drupchen/microdox-tent/docs/build_preview.3mf

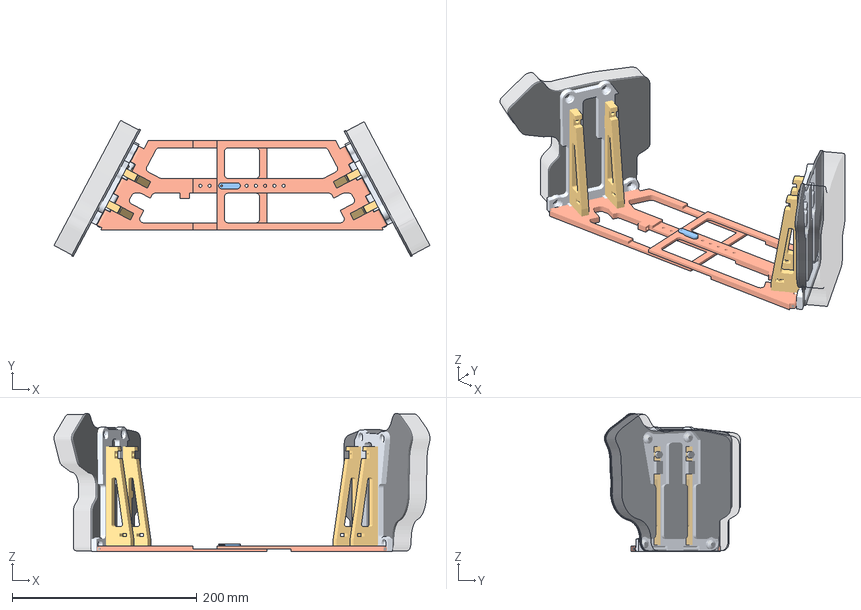
[picture p3: CAD file, 2026-11-09]
docs/build_preview.3mf
406.5 x 147.5 x 149.6 mm
