drupchen/microdox-tent/stl/vertical/print_set.3mf

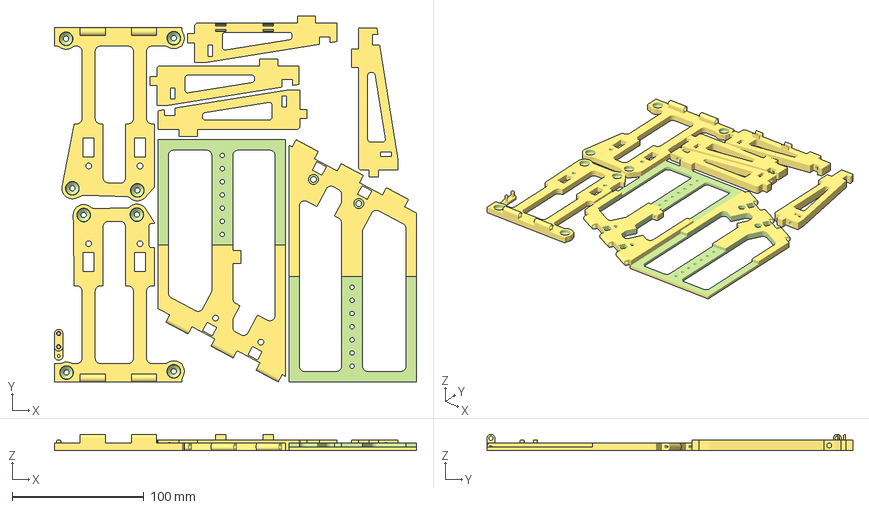
[picture p4: CAD file, 2026-11-09]
stl/vertical/print_set.3mf
275.0 x 277.9 x 12.5 mm
