drupchen/microdox-tent/trackball_retainer.stl

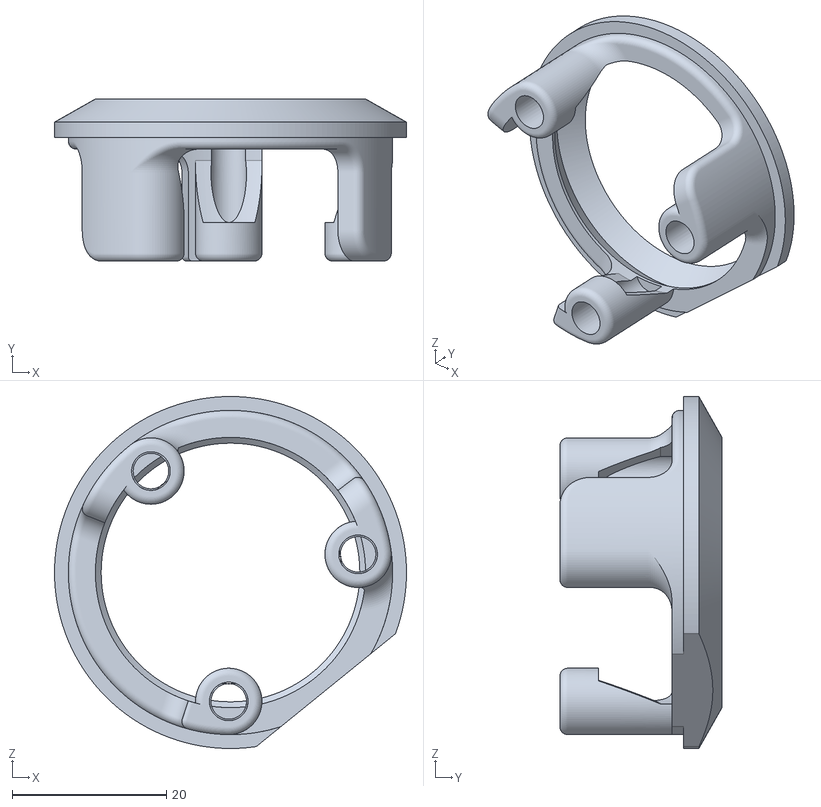
[picture p5: CAD file, 2026-11-09]
trackball_retainer.stl
45.6 x 21.0 x 45.6
