drupchen/microdox-tent/stl/vertical/spine_right.stl

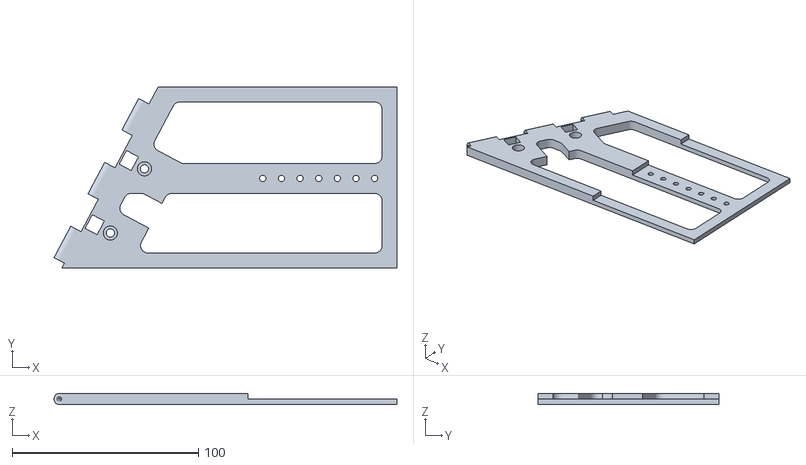
[picture p6: CAD file, 2026-11-09]
stl/vertical/spine_right.stl
184.0 x 97.0 x 6.00
