drupchen/microdox-tent/stl/vertical/haunch_key.stl

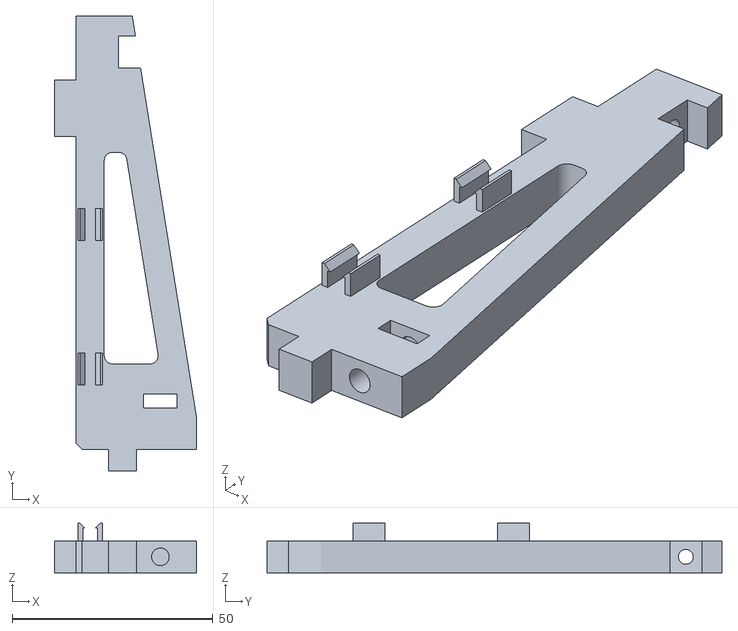
[picture p7: CAD file, 2026-11-09]
stl/vertical/haunch_key.stl
35.4 x 113.4 x 12.4
