drupchen/microdox-tent/stl/vertical/lap_staple.stl

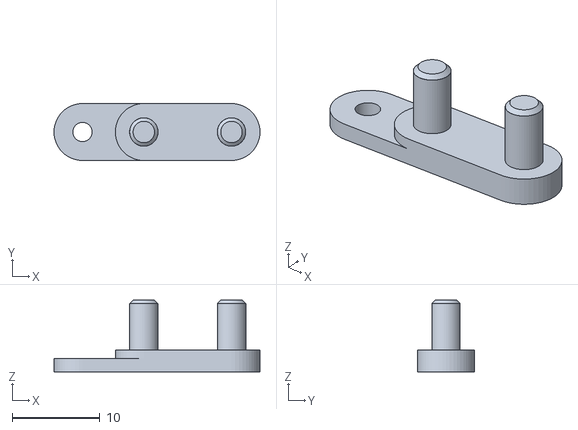
[picture p8: CAD file, 2026-11-09]
stl/vertical/lap_staple.stl
23.5 x 6.50 x 8.19
