drupchen/microdox-tent/stl/vertical/haunch.stl

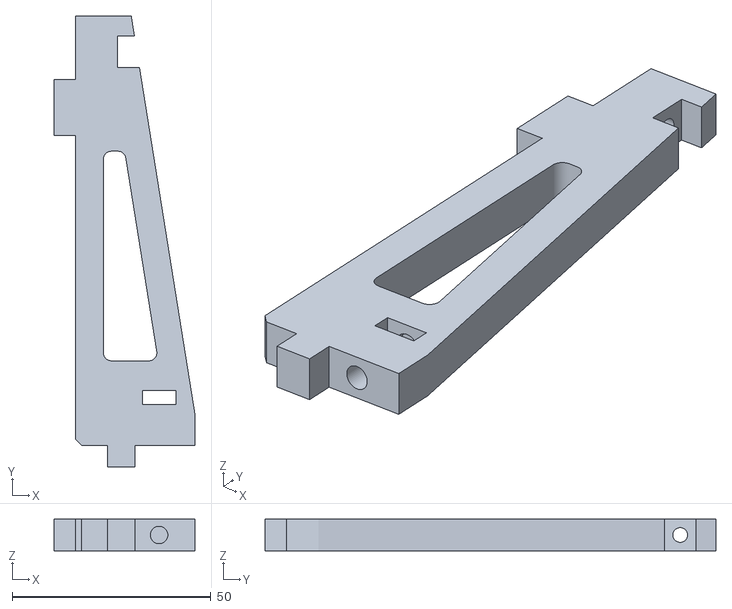
[picture p9: CAD file, 2026-11-08]
stl/vertical/haunch.stl
35.4 x 113.4 x 8.00
