drupchen/microdox-tent/stl/vertical/wall_right.stl

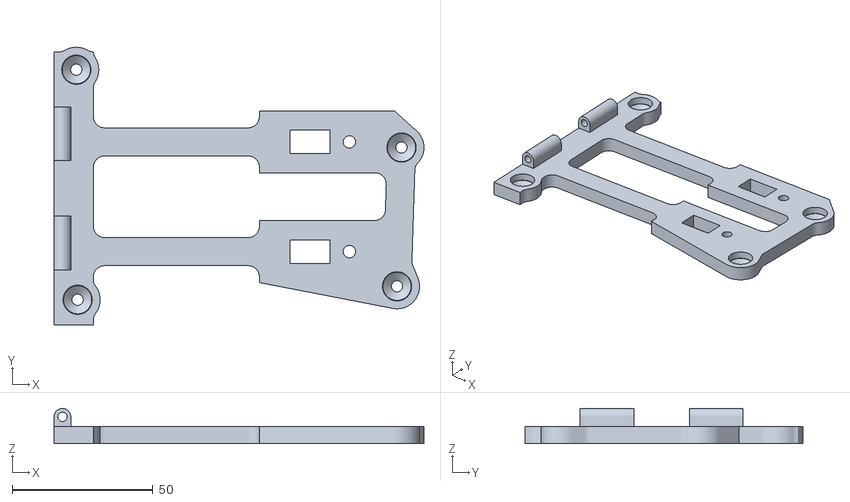
[picture p10: CAD file, 2026-11-08]
stl/vertical/wall_right.stl
131.5 x 98.6 x 12.5
