drupchen/microdox-tent/stl/vertical/wall_left.stl

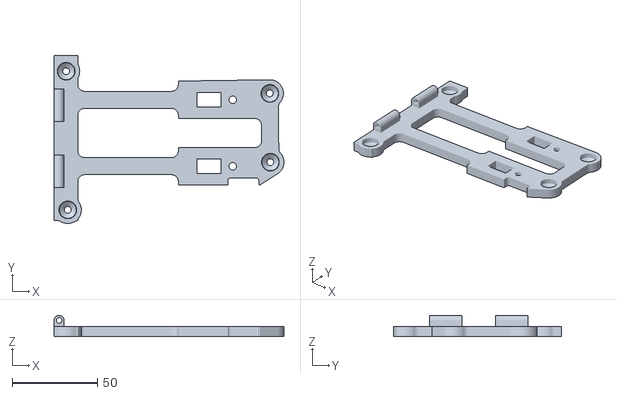
[picture p11: CAD file, 2026-11-08]
stl/vertical/wall_left.stl
135.1 x 98.6 x 12.5
