drupchen/microdox-tent/(list of files, cad)

Other CAD files:
stl/vertical/spine_left.stl
stl/vertical/print_set.stl
