drupchen/microdox-tent/(commit log)

2026-11-06 Rename project to Charybdis tent and update details
    Updated README to reflect project name change and enhancements for the Charybdis tenting stand, including design details and assembly instructions.
2026-11-07 90 deg: vertical stand, and the measurements that go with it
    The board is now vertical and staying there, so the target angle changes from
    "~70-75, to be found in cardboard" to a settled 90. That turns out to change the
    architecture, not just a number.
    cad/vertical.scad: a new stand, because the Ribs wedge cannot be re-parameterised
    to 90 - plate_in_x() collapses from ~87 mm at 30 deg to plate_t at 90, foot_x()
    goes negative and the ribs invert through the plate. Three flat plates per half
    (wall, two braces, base) slotted together; the wall passes through the base to the
    desk so load goes straight down. 86 g per half, 172 g the pair, against the ~400 g
    a 90 deg wedge would need. Wall and br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
    [base.stl, base_right.stl, brace.stl, microdox_ribs.scad, vertical.scad, wall.stl]
2026-11-07 docs: render of the vertical assembly
    Claude-Session: https://claude.ai/code/session_011RvQQieD5SvLoYgEtfii7x
2026-11-08 vertical: move the structure inboard; splay in the flange; rest kit
    The base-plate version of this file was wrong in two ways that reinforced
    each other. The plate was 62% of each half's mass and set a 318 x 105 mm
    footprint, and it put every bit of structure OUTBOARD, under the hands,
    while leaving the ~160 mm of air between the two vertical halves empty. At
    90 deg that gap is dead space - no hands, no keycaps, no cables - and it is
    the only place structure does not get in the way.
    Everything moved inboard. Two walls, and a spine between them whose outer
    ends turn up into flanges the walls bolt to face-to-face. No base plates, no
    braces, no feet: a bolted lap is already a moment connection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
    [base.stl, base_right.stl, brace.stl, carrier.stl, pad_ring_ref.scad, rest_arm.stl, spine_left.stl, spine_right.stl]
2026-11-08 cad: Charybdis 4x6 bottom-plate geometry, from upstream's own files
    This is the measurement the whole project has been blocked on. Drupchen
    identified Bastardkb/charybdis files/4x6/MK1/plate_shield2.x.stl as matching
    his physical plate bar the on/off and reset openings, and that folder also
    ships plate_shield2.x.dxf - the 2D source, with exact circles rather than a
    faceted mesh.
    Eight CIRCLE entities in the DXF: six at 4.000 mm and two at 5.000 mm. The
    six are the mounting pattern; the two, 13.95 mm apart in one corner, are the
    button openings. Cross-checked by slicing the mesh at mid-thickness: all
    fifteen pairwise distances between the six holes agree with the DXF to
    within 0.01 mm, so th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
    [charybdis_ref.scad]
2026-11-08 cad: 1:1 verification template, and the pattern holds across revisions
    The bottom plates on Drupchen's build differ from upstream MK1 in at least
    three ways - the button openings are changed, the hole beside the USB-C is
    gone, and the left plate carries an opening where the right has the
    trackball, which MK1's has nowhere. So the outline cannot be assumed.
    The mounting pattern can. Cross-checked MK1 against MK2's separate left and
    right plates: all three give the same fifteen pairwise distances between
    the six holes, within 0.02 mm. Left and right are NOT different patterns,
    whatever else changes between revisions - MK2 has a bigger outline, 6 mm
    holes rather than 4, one button opening rath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
    [charybdis_ref.scad, charybdis_template.scad]
2026-11-08 cad: both plates identified from the tracings - Charybdis right, Scylla left
    Drupchen traced both bottom plates on A4. Correcting each photo's perspective
    against the sheet's known 210 x 297 mm and detecting the drawn holes gives
    six centres per plate, and comparing the fifteen pairwise distances against
    upstream settles which plate is which:
    right-hand tracing vs Charybdis MK1 rms 0.51 mm (scale 1.0175)
    right-hand tracing vs Scylla MK1 rms 5.89 mm
    left-hand tracing vs Charybdis MK1 rms 6.30 mm
    left-hand tracing vs Scylla MK1 rms 0.58 mm (scale 0.9990)
    So the halves carry plates from two different boards. That is not a clone
    oddity: it is what the wrist-pad mo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
    [charybdis_ref.scad, scylla_ref.scad]
2026-11-08 cad: locate the reset plunger and cable opening on both plates
    The keyhole shape in both tracings is not an opening. The photos show it is
    a raised dome on a flexure - a tab with a slot cut round it so you can press
    through to the reset switch. It stands proud of the plate's outer face,
    which is exactly the face a stand bolts against, so it needs clearance AND
    room to flex, or reset becomes a teardown.
    Located by mapping each tracing into its plate's frame through the six
    holes: 0.46 mm rms on the right, 0.57 mm on the left, so these positions are
    good to about half a millimetre.
    Both plates also replace the stock pair of 5.0 mm openings with a ~13 mm
    square cable opening plus the plunger,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
    [charybdis_ref.scad, scylla_ref.scad]
2026-11-08 cad: the reset dome is on the inside, not the outside
    Corrects the previous commit. The ruler photos are of the plates' INNER
    faces: the battery tray and the plunger's dome both protrude inward. You
    press the flexure tab from outside and the dome pushes the switch on the
    PCB.
    So the outer face - the one a stand bolts against - is flat, and the wall
    needs no relief pockets at all. It needs one through-hole at the plunger so
    the tab stays reachable, which is easier and leaves the wall stiffer than
    the pocket I had planned.
    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
    [charybdis_ref.scad, scylla_ref.scad]
2026-11-08 docs: handoff for continuing this on a local machine
    Everything established so far, with how it was established, plus the things
    that were got wrong and corrected - the wrong version is usually the
    intuitive one and would otherwise be re-derived. Covers both repos, the
    plate identification, the firmware state and its gotchas, the stand's design
    reasoning, the local tooling, and what to do next.
    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
2026-11-08 Vertical stand: M4 haunch joints, 270 mm centre gap, key clip, lap pins; drop everything else
    - Haunches 8 mm thick, one M4 x 16 at each end (nut in the wall's board face,
    screw from the haunch's edge; foot screw up from under the plate), so nothing
    under the board is undone to fold. Separate wall_left / wall_right parts.
    - Gap 270 mm on the centreline (22 cm between the boards at their closest),
    asserted as the middle of a 250-290 mm range on the lap hole row.
    - haunch_key: one haunch carries a snap clip for the 3 mm hex key.
    - lap_pin: printed pins through the lined-up lap holes, replacing M3 bolts.
    - Removed the upstream wedge, its exports and tools, the fit template,
    HANDOFF.md,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
    [Microdox.step, carrier.stl, charybdis_template.scad, coupler.stl, fit_plate.stl, haunch.stl, haunch_key.stl, joint_test_socket.stl]
2026-11-09 Lap staple with a string lug; key clip without the tip stop
    - lap_staple replaces the six loose pins: two 3.25 mm pins one hole pitch
    apart under a bridge, so one part fits every gap (250-290). A raised tab
    takes a string.
    - spine_left gets a lug on the near side of its centre bar, just outboard
    of the lap, with a hole along the bar for that string. In the plate's
    plane, so the wall still folds flat.
    - haunch_key: the block under the key's tip is gone; the two snap clips
    hold the key on their own.
    [haunch_key.stl, lap_pin.stl, lap_staple.stl, spine_left.stl, vertical.scad]
2026-11-09 print_set: the whole stand in one file, laid out flat
    All nine parts (two walls, two spine plates, three haunches, the key
    haunch and the staple) in their print orientation, 5 mm apart, ~346 x 303 mm.
    Exported as STL and 3MF.
    [print_set.3mf, print_set.stl, vertical.scad]
2026-11-09 Build preview, tighter README images, trackball retainer
    - docs/build_preview.3mf: the whole build assembled at the 270 mm gap,
    in colour, boards as approximate stand-ins. For viewing, not printing.
    - docs/images/assembly_vertical.png re-rendered tight; assembly_top.png
    added (splay and lap hole row seen from above).
    - README: both images, the stand-in caveat, the preview file and how to
    regenerate it.
    - trackball_retainer.stl: the retainer for the 34 mm ball at 90 degrees,
    added by Drupchen.
    [build_preview.3mf, trackball_retainer.stl]
2026-11-09 spine_right: export it turned over so the lap lies on the bed
    Its half-lap is cut from the desk face, so as modelled the 80 mm lap end
    hung 3 mm above the bed (~3000 mm2 of bridging). Now exported rotated
    180 deg about x (still the right hand): whole underside on the bed, same
    footprint and volume, the haunch-foot counterbores opening upward.
    print_set uses the same flipped part; bounds unchanged. README notes it.
    [print_set.3mf, print_set.stl, spine_right.stl, vertical.scad]
2026-11-09 print_set: nest the parts into 275 x 278 mm
    Was 346 x 303 mm with 5 mm gaps. A search over part order and
    quarter-turns, minimising the larger side, packs all nine parts with at
    least 2 mm between them (2.35 mm measured on the real outlines):
    haunches head to tail, spines side by side, staple in a corner. Parts are
    only turned, never mirrored, so each still prints face down. Fits a
    300 x 300 mm bed; same volume as before. README updated, with the note
    that a brim wants ~6 mm and the single-part files then.
    [print_set.3mf, print_set.stl, vertical.scad]
